Arie001/ambovent_pcb_Rev_Arie/respirator-control_rev2/cable.png

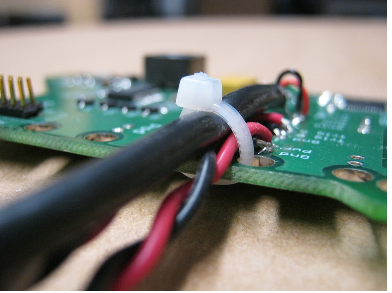
respirator-control_rev2/cable.png
