Arie001/ambovent_pcb_Rev_Arie/respirator-control_rev2/BRGz0.jpg

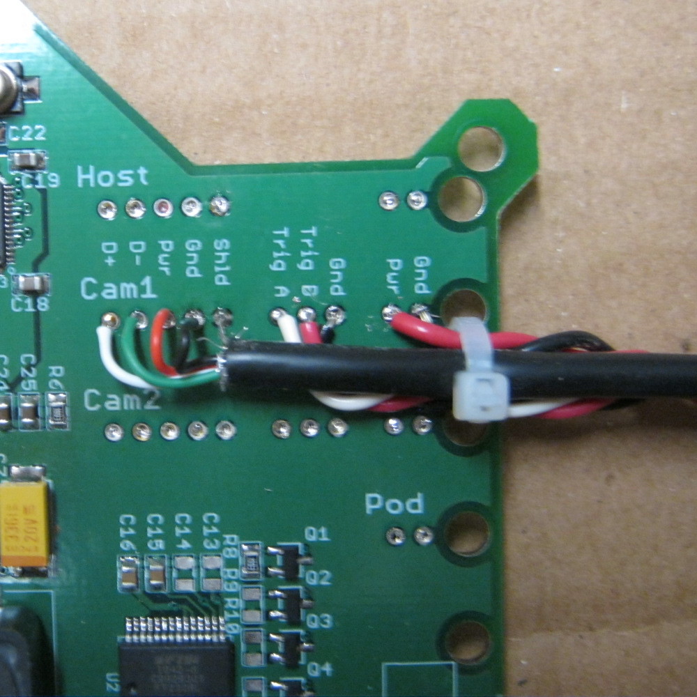
respirator-control_rev2/BRGz0.jpg
