Arie001/ambovent_pcb_Rev_Arie/README.md

# ambovent_pcb_Rev_Arie
This is a PCB  make in Kicad that is made to combine most of the design of the open project
Very Much work in Progress  

I have Just Change  the Direction of the Connectors and added a Securing Point  
the Gerbers Are Not Up todate 

It is 3:30 Am
