Arie001/ambovent_pcb_Rev_Arie/respirator-control_rev2/respirator-control_rev2.jpg

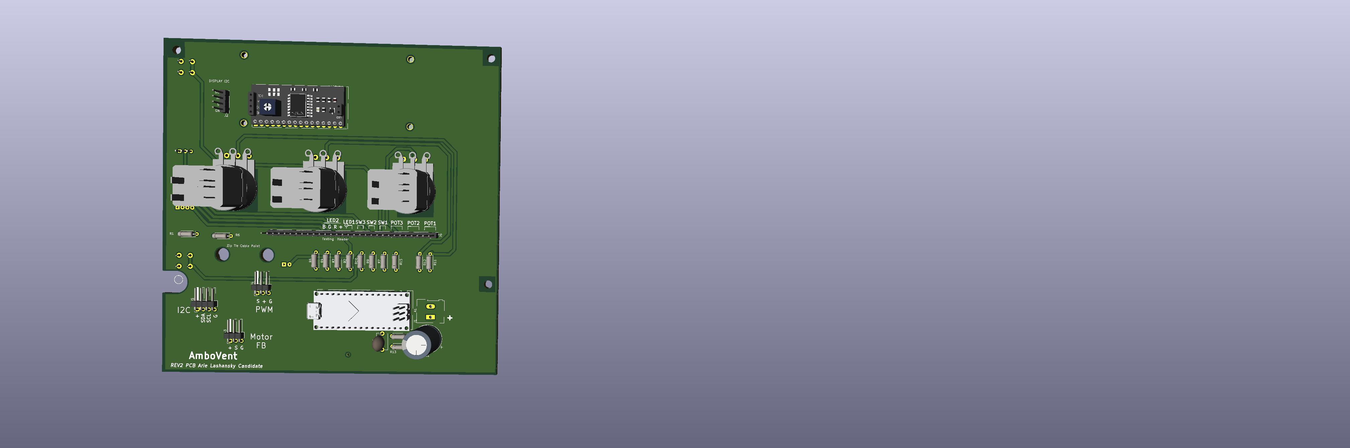
respirator-control_rev2/respirator-control_rev2.jpg
