Arie001/ambovent_pcb_Rev_Arie/respirator-control_rev2/respirator-control_rev2.kicad_pcb

## KiCad design respirator-control_rev2/respirator-control_rev2.kicad_pcb (2020-05-04)

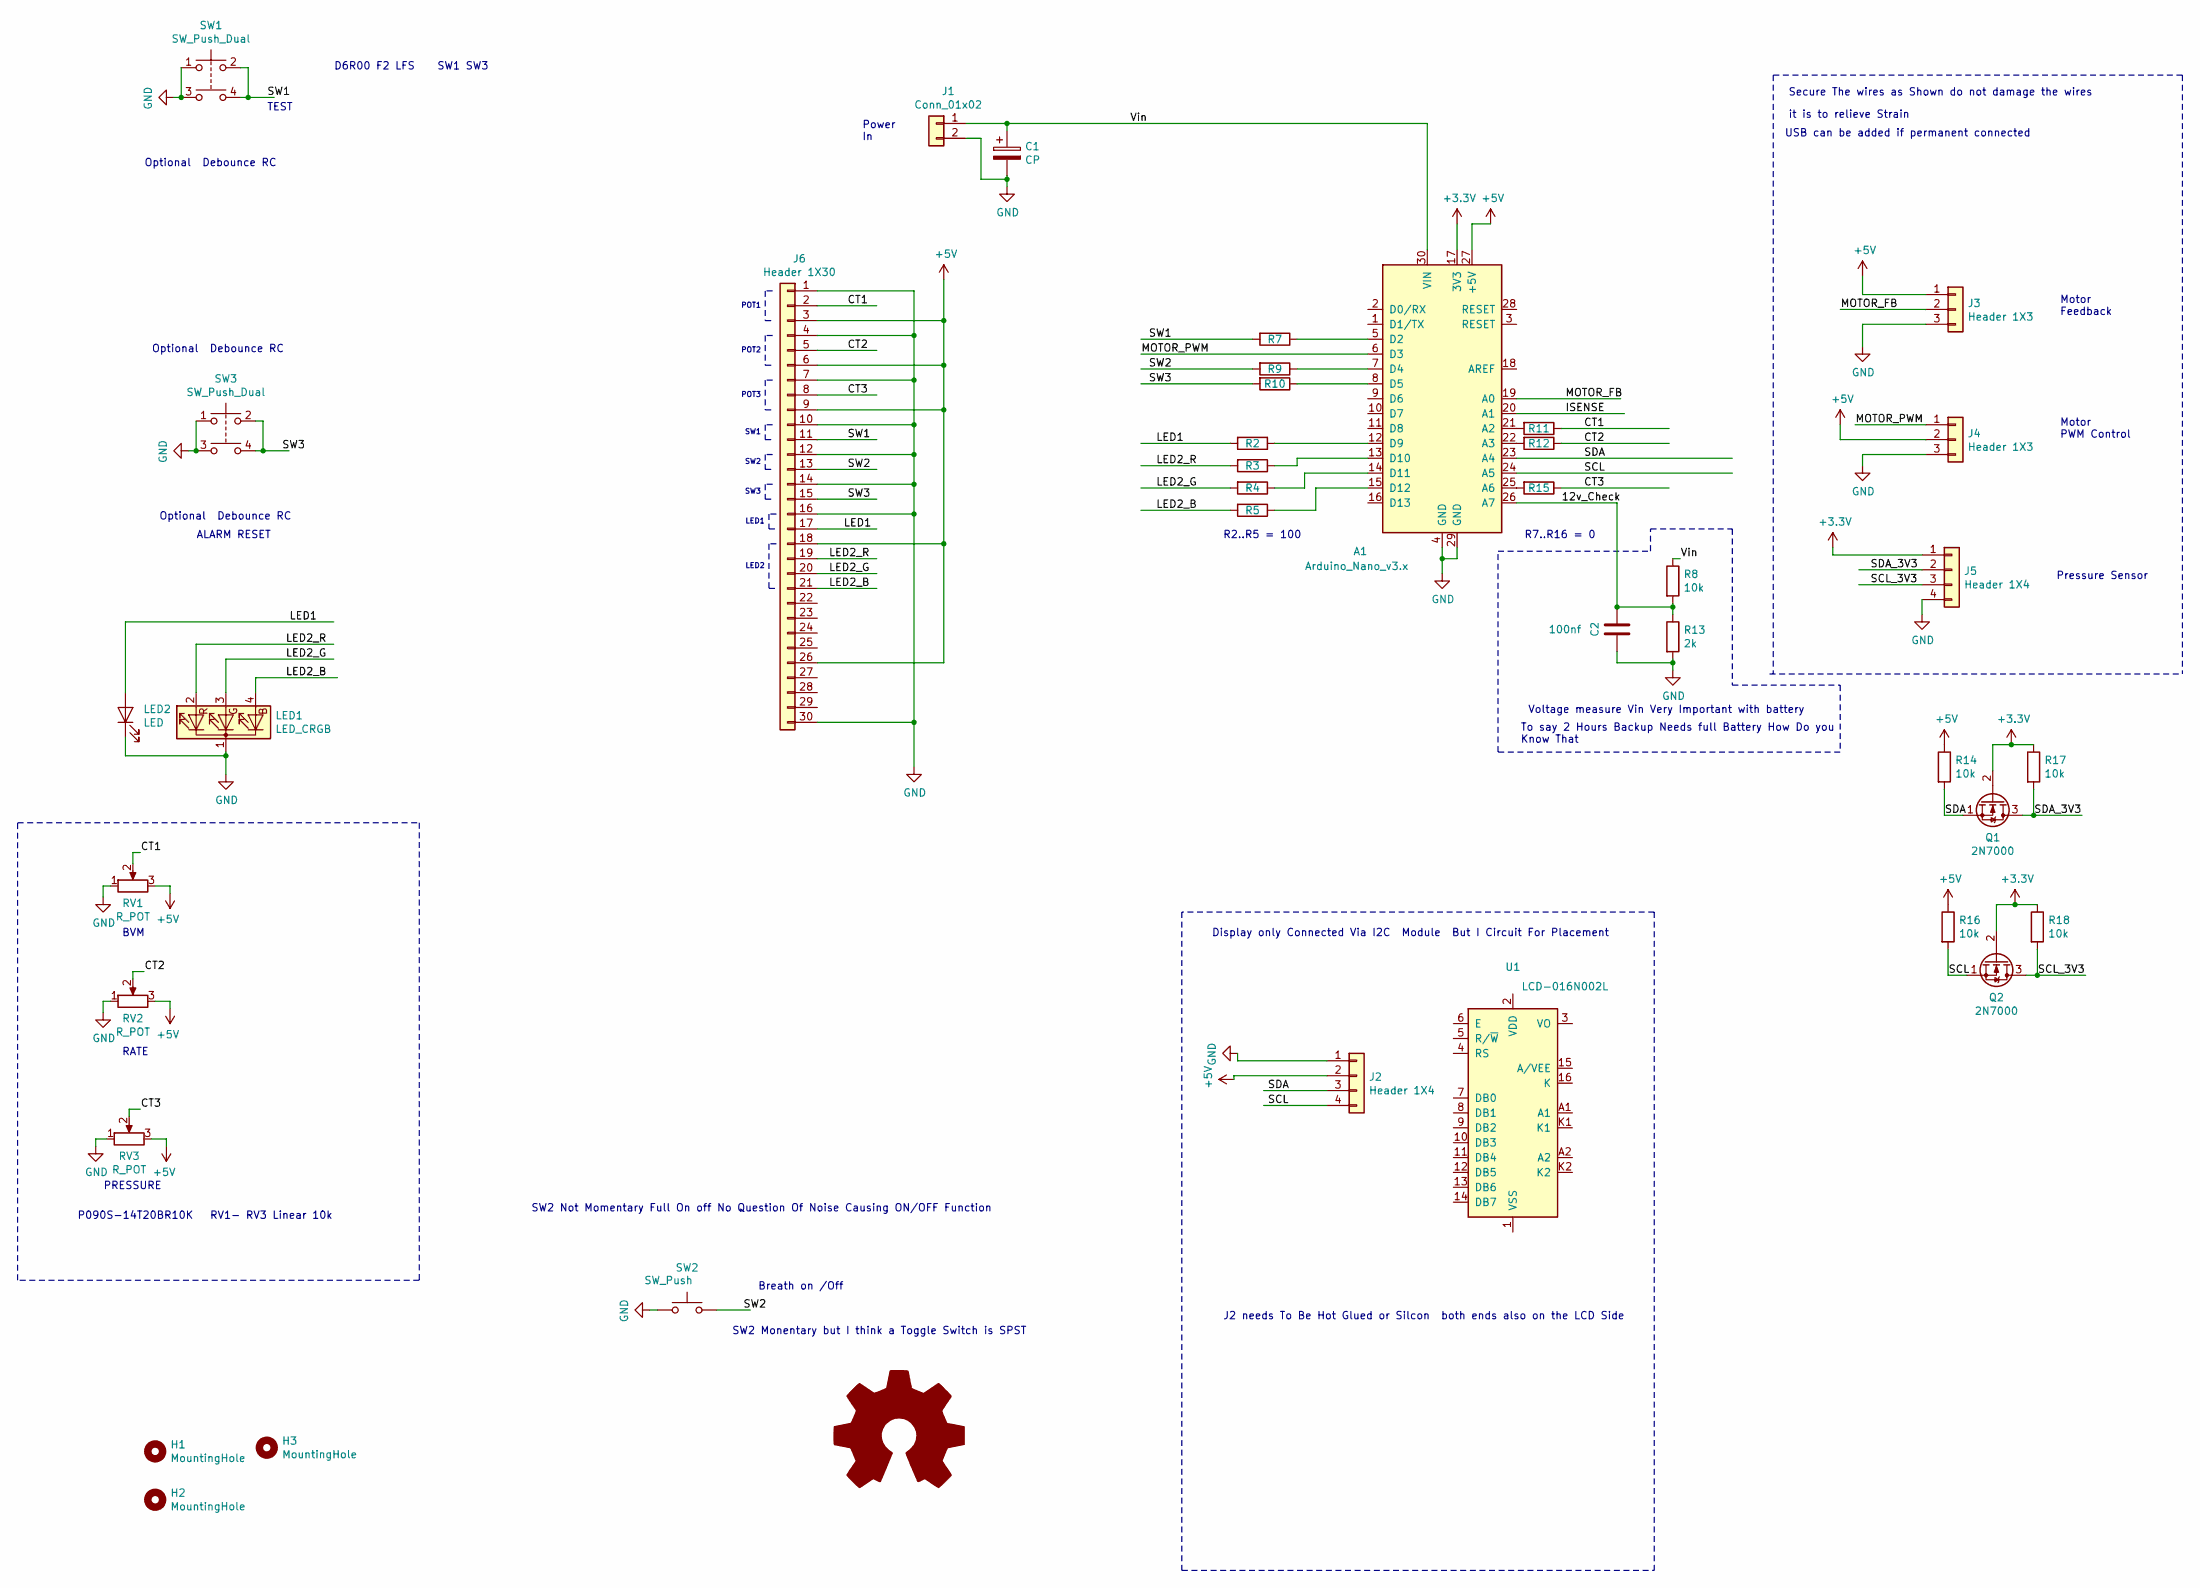
[picture p4: schematic respirator-control_rev2.sch, AmboVent Control Board]

Parts:
A1: Arduino_Nano_v3.x; Arduino_Nano
C1: CP; CP_Radial_D13.0mm_P5.00mm
C2: 100nf; C_Disc_D7.5mm_W5.0mm_P7.50mm
H1, H2, H3: MountingHole; MountingHole_3.2mm_M3
J1: Conn_01x02; TerminalBlock_Altech_AK300-2_P5.00mm
J2: Header 1X4; PinHeader_1x04_P2.54mm_Vertical
J3, J4: Header 1X3; PinHeader_1x03_P2.54mm_Horizontal
J5: Header 1X4; PinHeader_1x04_P2.54mm_Horizontal
J6: Header 1X30; PinHeader_1x30_P2.54mm_Vertical
LED1: LED_CRGB; LED_D5.0mm-4_RGB_Wide_Pins
LED2: LED; LED_D5.0mm_Clear
Q1, Q2: 2N7000; TO-92_Inline
R2, R3, R4, R5, R7, R9, R10, R11, R12, R15: 100; R_Axial_DIN0207_L6.3mm_D2.5mm_P7.62mm_Horizontal
R8, R14, R16, R17, R18: 10k; R_Axial_DIN0207_L6.3mm_D2.5mm_P7.62mm_Horizontal
R13: 2k; R_Axial_DIN0207_L6.3mm_D2.5mm_P7.62mm_Horizontal
RV1, RV2, RV3: R_POT; Potentiometer_old_school
SW1, SW3: SW_Push_Dual; D6R00F2LFS
SW2: SW_Push; eswitch_200MSP
U1: LCD-016N002L; WC1602A

Connections:
+3V3: A1.17 (3V3), J5.1, Q1.2 (G), Q2.2 (G), R17.1, R18.1
+5V: A1.27 (+5V), J2.2, J3.1, J4.2, J6.3, J6.6, J6.9, J6.18, J6.26, R14.1, R16.1, RV1.3, RV2.3, RV3.3
/12v_Check: A1.26 (A7), C2.2, R8.2, R13.1
/CT1: J6.2, R11.1, RV1.2
/CT2: J6.5, R12.1, RV2.2
/CT3: J6.8, R15.1, RV3.2
/ISENSE: A1.20 (A1)
/LED1: J6.17, LED2.2 (A), R2.2
/LED2_B: J6.21, LED1.4 (BA), R5.2
/LED2_G: J6.20, LED1.3 (GA), R4.2
/LED2_R: J6.19, LED1.2 (RA), R3.2
/MOTOR_FB: A1.19 (A0), J3.2
/MOTOR_PWM: A1.6 (D3), J4.1
/SCL: A1.24 (A5), J2.4, Q2.1 (S), R16.2
/SCL_3V3: J5.3, Q2.3 (D), R18.2
/SDA: A1.23 (A4), J2.3, Q1.1 (S), R14.2
/SDA_3V3: J5.2, Q1.3 (D), R17.2
/SW1: J6.11, R7.2, SW1.2, SW1.4
/SW2: J6.13, R9.2, SW2.2
/SW3: J6.15, R10.2, SW3.2, SW3.4
/Vin: A1.30 (VIN), C1.1, J1.1, R8.1
GND: A1.4 (GND), A1.29 (GND), C1.2, C2.1, J1.2, J2.1, J3.3, J4.3, J5.4, J6.1, J6.4, J6.7, J6.10, J6.12, J6.14, J6.16, J6.30, LED1.1 (K), LED2.1 (K), R13.2, RV1.1, RV2.1, RV3.1, SW1.1, SW1.3, SW2.1, SW3.1, SW3.3
unnamed: A1.5 (D2), R7.1
unnamed: A1.7 (D4), R9.1
unnamed: A1.8 (D5), R10.1
unnamed: A1.12 (D9), R2.1
unnamed: A1.13 (D10), R3.1
unnamed: A1.14 (D11), R4.1
unnamed: A1.15 (D12), R5.1
unnamed: A1.21 (A2), R11.2
unnamed: A1.22 (A3), R12.2
unnamed: A1.25 (A6), R15.2

Notes on the sheet:
Power In
R2..R5 = 100
Motor Feedback
Motor PWM Control
SW1
SW2
SW3
POT1
POT2
POT3
LED1
LED2
R7..R16 = 0
Pressure Sensor
Optional Debounce RC
BVM
RATE
PRESSURE
ALARM RESET
Breath on /Off
SW2 Monentary but I think a Toggle Switch is SPST
TEST
Voltage measure Vin Very Important with battery
To say 2 Hours Backup Needs full Battery How Do you Know That
Display only Connected Via I2C Module But I Circuit For Placement
P090S-14T20BR10K RV1- RV3 Linear 10k
D6R00 F2 LFS SW1 SW3
SW2 Not Momentary Full On off No Question Of Noise Causing ON/OFF Function
J2 needs To Be Hot Glued or Silcon both ends also on the LCD Side
Secure The wires as Shown do not damage the wires
it is to relieve Strain
USB can be added if permanent connected

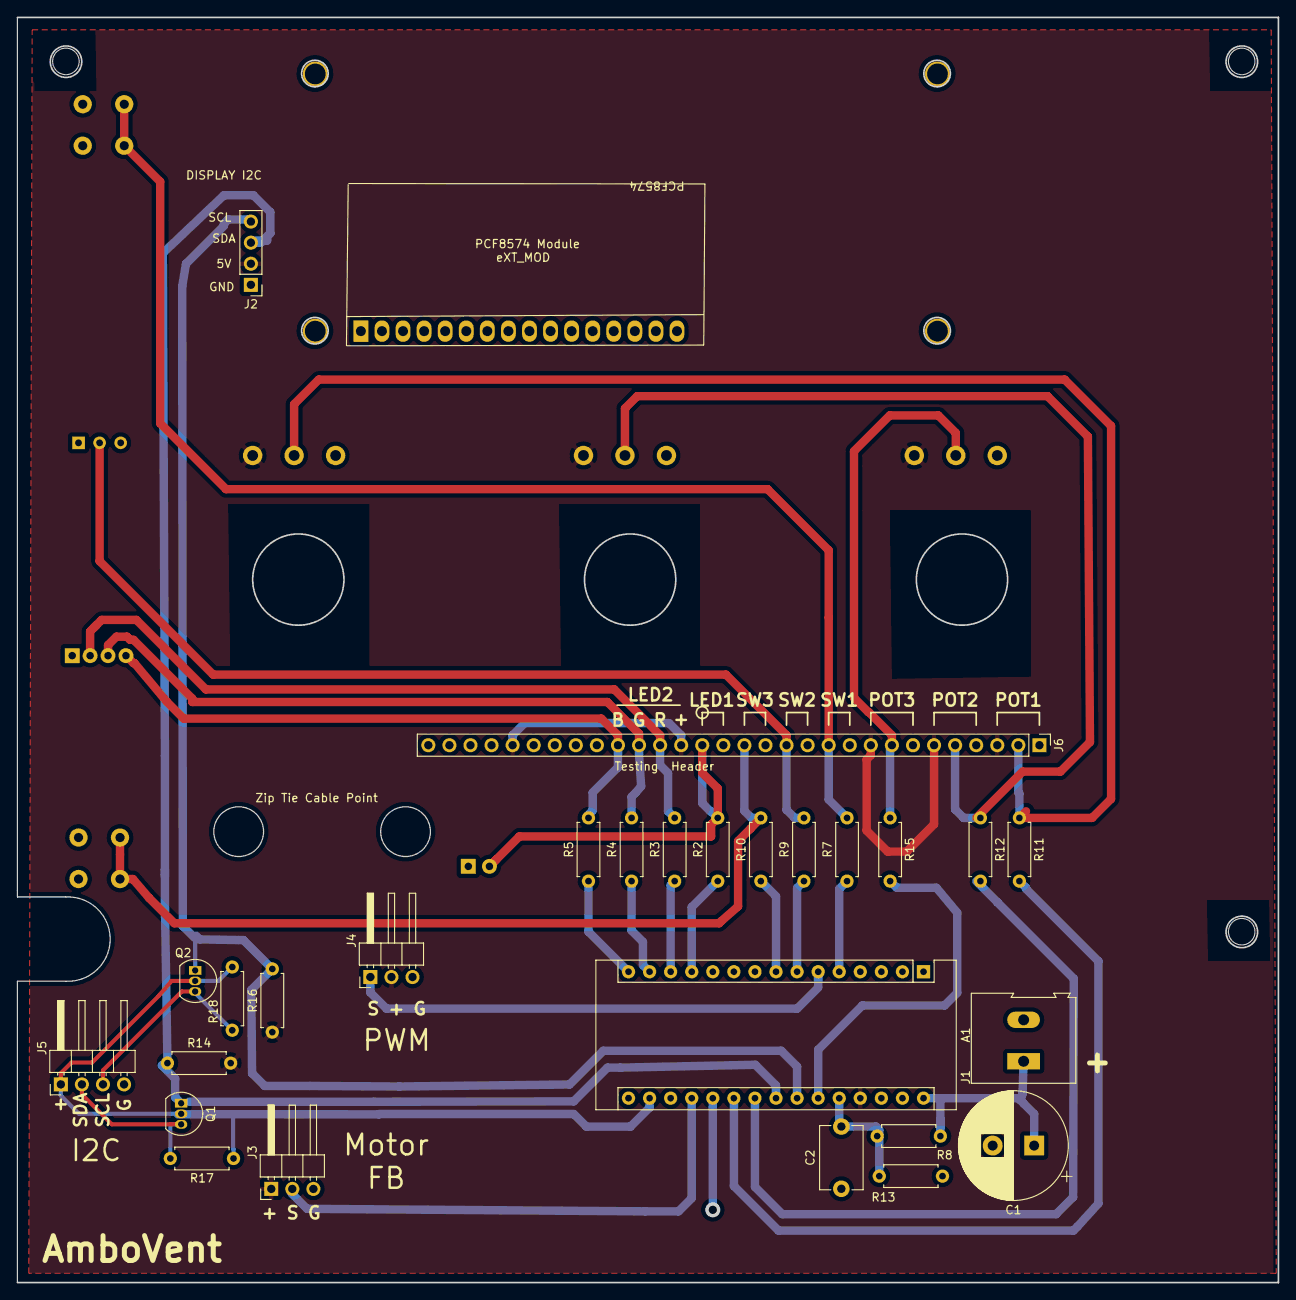
[picture p5: board respirator-control_rev2.kicad_pcb from above]

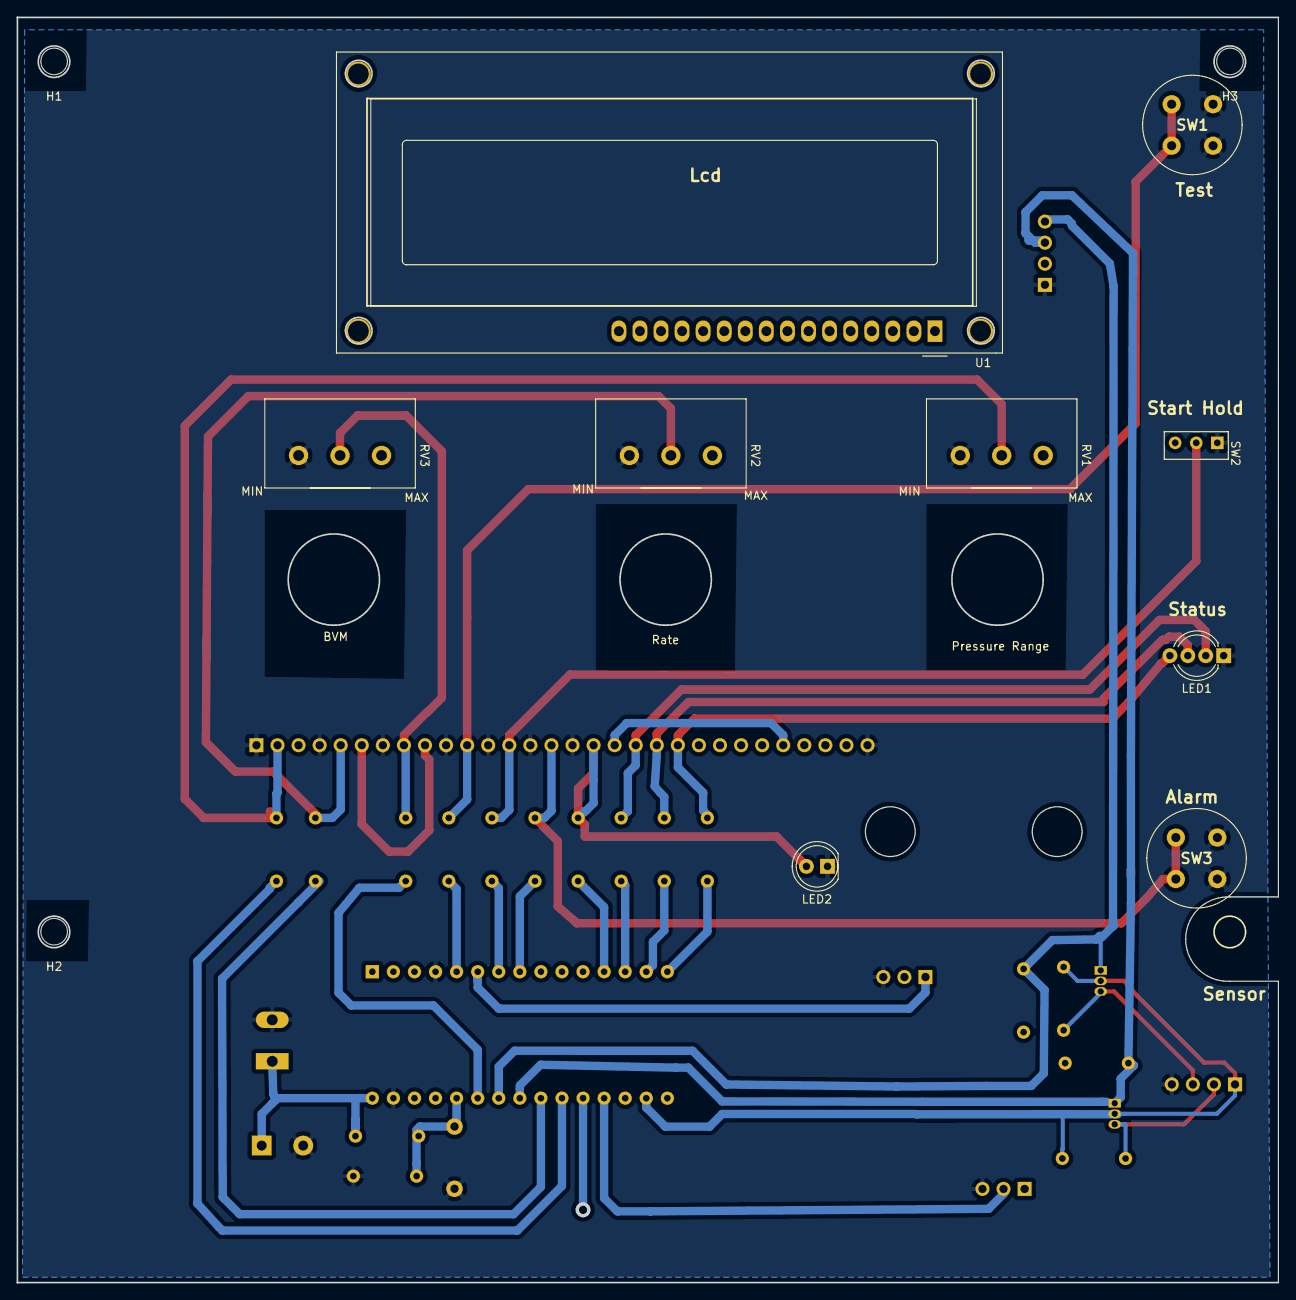
[picture p6: board respirator-control_rev2.kicad_pcb from below]

Board: 2 copper layers, 152.0 x 152.5 mm, 40 parts (12 on the bottom side), 31 nets.

Other parts of the board:
eXT_MOD: i2c-1602
