Arie001/ambovent_pcb_Rev_Arie/(threads)

Thread 1 (2020-04-13):

5v  logic on 3.3v Max sensor

Arie001, 2020-04-13:
While  Doing  transfer to ESP32  from Atmel I found a Problem
I will not Produce a 16mhz  Version  and the 2*4.7k  pullups need to be removed

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

Arie001, 2020-04-14:
Spark Fun say it is OK
But My Future Version  will not have 5V logic  only 3.3

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

Arie001, 2020-04-14:
I need to think about it but the Datasheet is clear

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

Arie001, 2020-04-23:
Not a simple issue  I am parasnoide

https://www.microchip.com/forums/m911941.aspx

Arie001, 2020-05-02:
The module from seeed studio use a simple level shift
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

Arie001, 2020-05-06:
done close issue

Closed 2020-05-06.
