Arie001/ambovent_pcb_Rev_Arie/(commit log)

2020-04-13 Add files via upload
    Change Connectors to horizontal from veritical add Point To secure Cables .
    add JPG to Sch to show How to secure Cables.
    Gerber in Not Updated and Not Checked In Fusion .
    [respirator-control_rev2.kicad_pcb, respirator-control_rev2.sch]
2020-05-04 Add files via upload
    Add level convert SCL SDA
    [respirator-control_rev2-B_Cu.gbr, respirator-control_rev2-B_Fab.gbr, respirator-control_rev2-B_Mask.gbr, respirator-control_rev2-B_SilkS.gbr, respirator-control_rev2-Edge_Cuts.gbr, respirator-control_rev2-F_Cu.gbr, respirator-control_rev2-F_Fab.gbr, respirator-control_rev2-F_Mask.gbr]
